MaZderMind/jukebox/hardware/pi-hat/3d/front.png

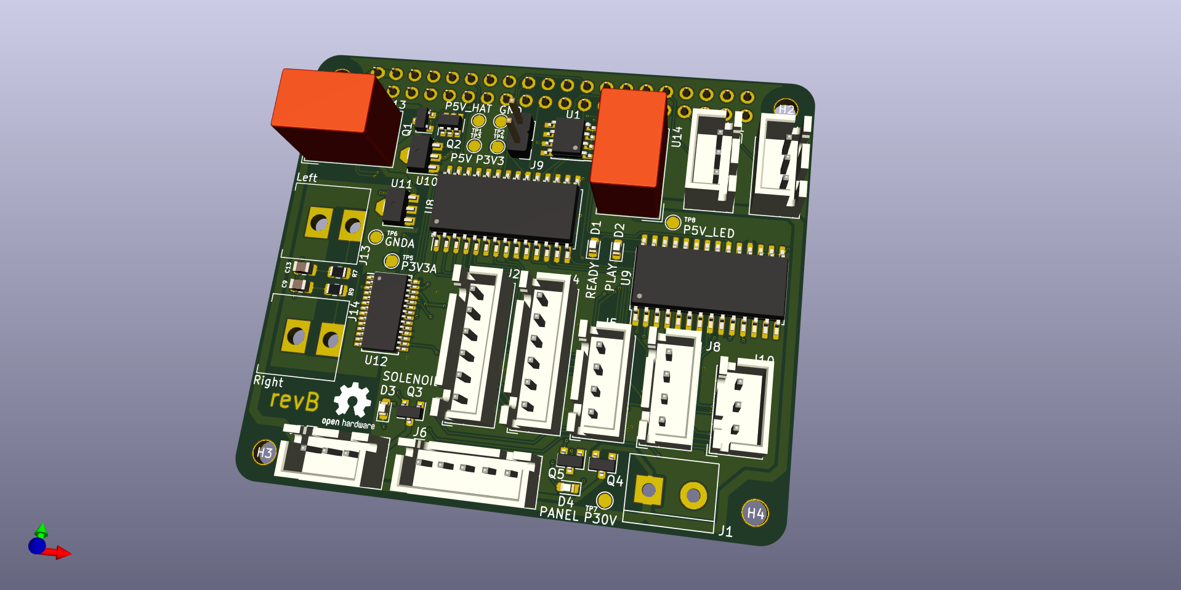
hardware/pi-hat/3d/front.png
