MaZderMind/jukebox/hardware/pi-hat/3d/back.png

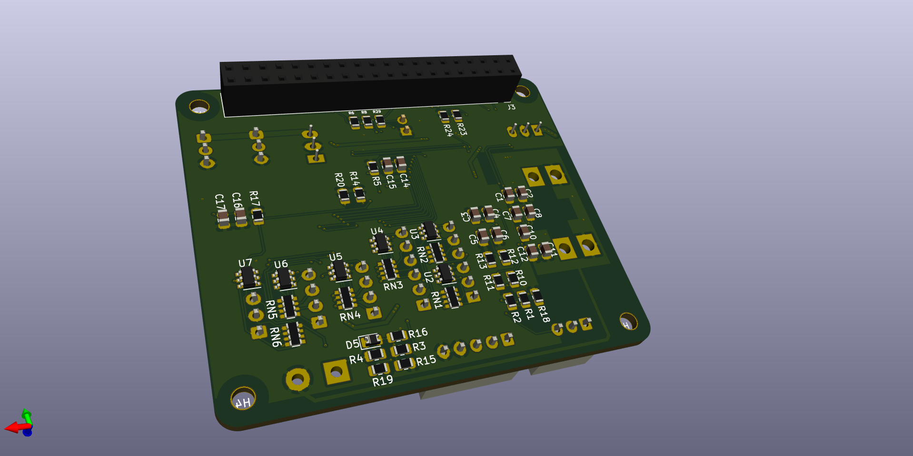
hardware/pi-hat/3d/back.png
