MaZderMind/jukebox/config/README.md

# Compile jukebox-Device-Tree
…

# Enable Device-Tree-Overlays
Add to /boot/config.txt

```
dtoverlay=jukebox
dtoverlay=hifiberry-dacplus
```
