MaZderMind/jukebox/hardware/pi-hat/schematic.pdf

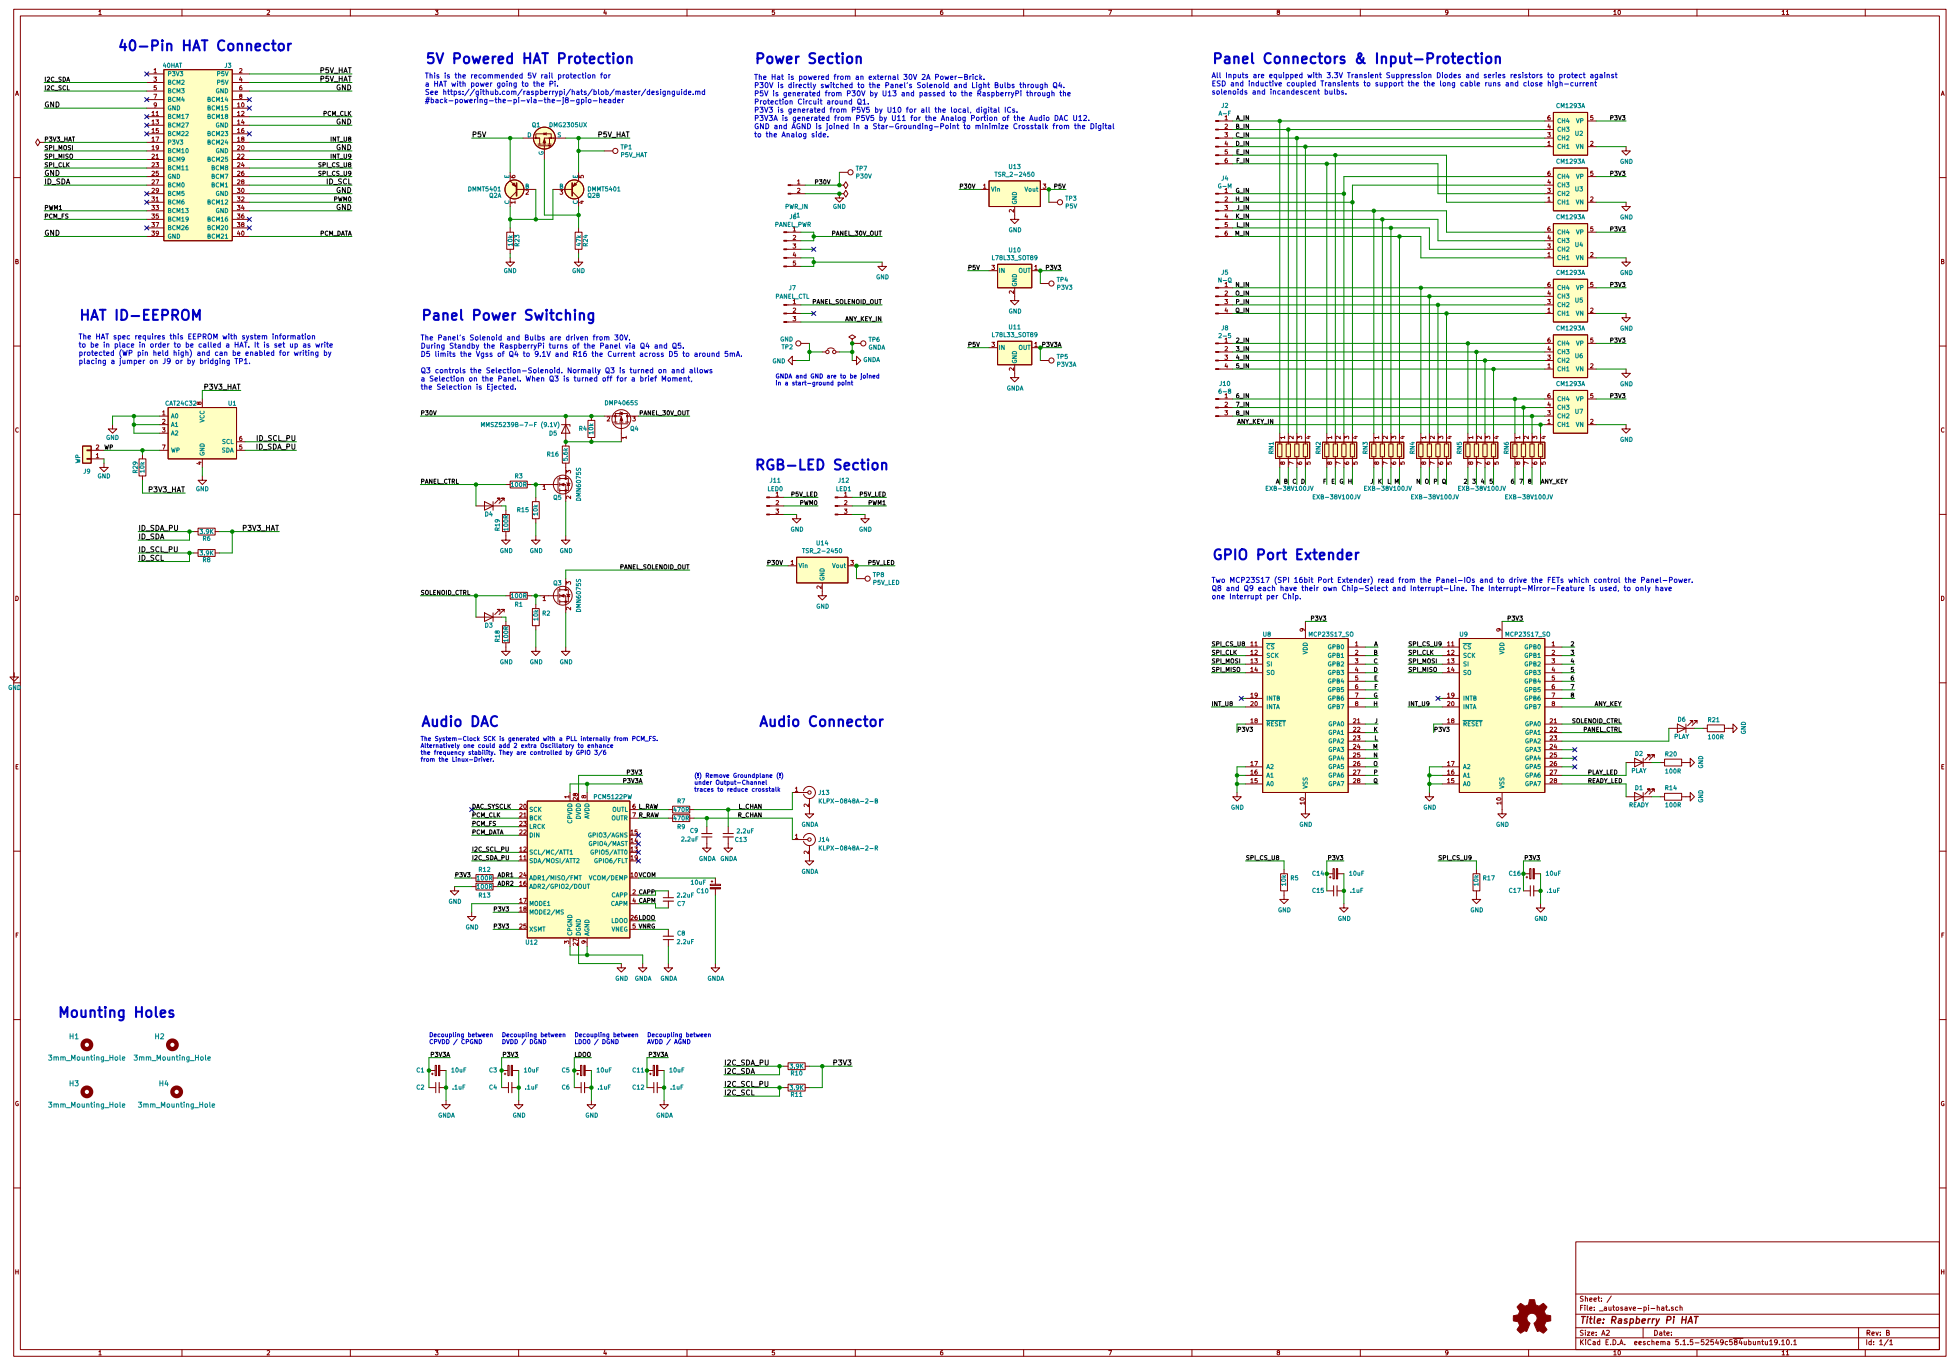
[picture p3: page 1]

ESD and inductive coupled Transients to support the the long cable runs and close high-current solenoids and incandescent bulbs. This is the recommended 5V rail protection for
a HAT with power going to the Pi.
See https://github.com/raspberrypi/hats/blob/master/designguide.md
#back-powering-the-pi-via-the-j8-gpio-header

The Hat is powered from an external 30V 2A Power-Brick.
P30V is directly switched to the Panel's Solenoid and Light Bulbs through Q4.
P5V is generated from P30V by U13 and passed to the RaspberryPi through the
Protection Circuit around Q1.
P3V3 is generated from P5V5 by U10 for all the local, digital ICs.
P3V3A is generated from P5V5 by U11 for the Analog Portion of the Audio DAC U12.
GND and AGND is joined in a Star-Grounding-Point to minimize Crosstalk from the Digital
to the Analog side.

All Inputs are equipped with 3.3V Transient Suppression Diodes and series resistors to protect against

The HAT spec requires this EEPROM with system information
to be in place in order to be called a HAT. It is set up as write
protected (WP pin held high) and can be enabled for writing by
placing a jumper on J9 or by bridging TP1.

8 A0 1 A1 2 A2 3 SDA 5 SCL 6 WP 7CAT24C32 U1 TP6 GNDA

The Panel's Solenoid and Bulbs are driven from 30V.
During Standby the RaspberryPi turns of the Panel via Q4 and Q5.
D5 limits the Vgss of Q4 to 9.1V and R16 the Current across D5 to around 5mA.

Q3 controls the Selection-Solenoid. Normally Q3 is turned on and allows
a Selection on the Panel. When Q3 is turned off for a brief Moment,
the Selection is Ejected.

GNDA and GND are to be joined
in a start-ground point

Two MCP23S17 (SPI 16bit Port Extender) read from the Panel-IOs and to drive the FETs which control the Panel-Power.
Q8 and Q9 each have their own Chip-Select and Interrupt-Line. The Interrupt-Mirror-Feature is used, to only have
one Interrupt per Chip.

The System-Clock SCK is generated with a PLL internally from PCM_FS.
Alternatively one could add 2 extra Oscillatory to enhance
the frequency stability. They are controlled by GPIO 3/6

(!) Remove Groundplane (!)
under Output-Channel traces to reduce crosstalk
3.9K GNDA GNDA

1 VCOM/DEMP 10 SDA/MOSI/ATT2 11 SCL/MC/ATT1 12 GPIO5/ATT0 13 GPIO4/MAST 14 GPIO3/AGNS 15 ADR2/GPIO2/DOUT 16 MODE1 17 MODE2/MS 18 GPIO6/FLT 19 CAPP 2 SCK 20 BCK 21 DIN 22

3 CAPM 4 VNEG 5 OUTL 6 OUTR 7 AVDD

R_RAW | 470R
LRCK 23 ADR1/MISO/FMT 24 XSMT 25

P3V3 | LDOO

Decoupling between CPVDD / CPGND

Decoupling between DVDD / DGND

Decoupling between AVDD / AGND

Id: 1/1 Title: Raspberry Pi HAT
