MaZderMind/jukebox/hardware/pi-hat/pi-hat.kicad_pcb

## KiCad design hardware/pi-hat/pi-hat.kicad_pcb (2020-01-15)

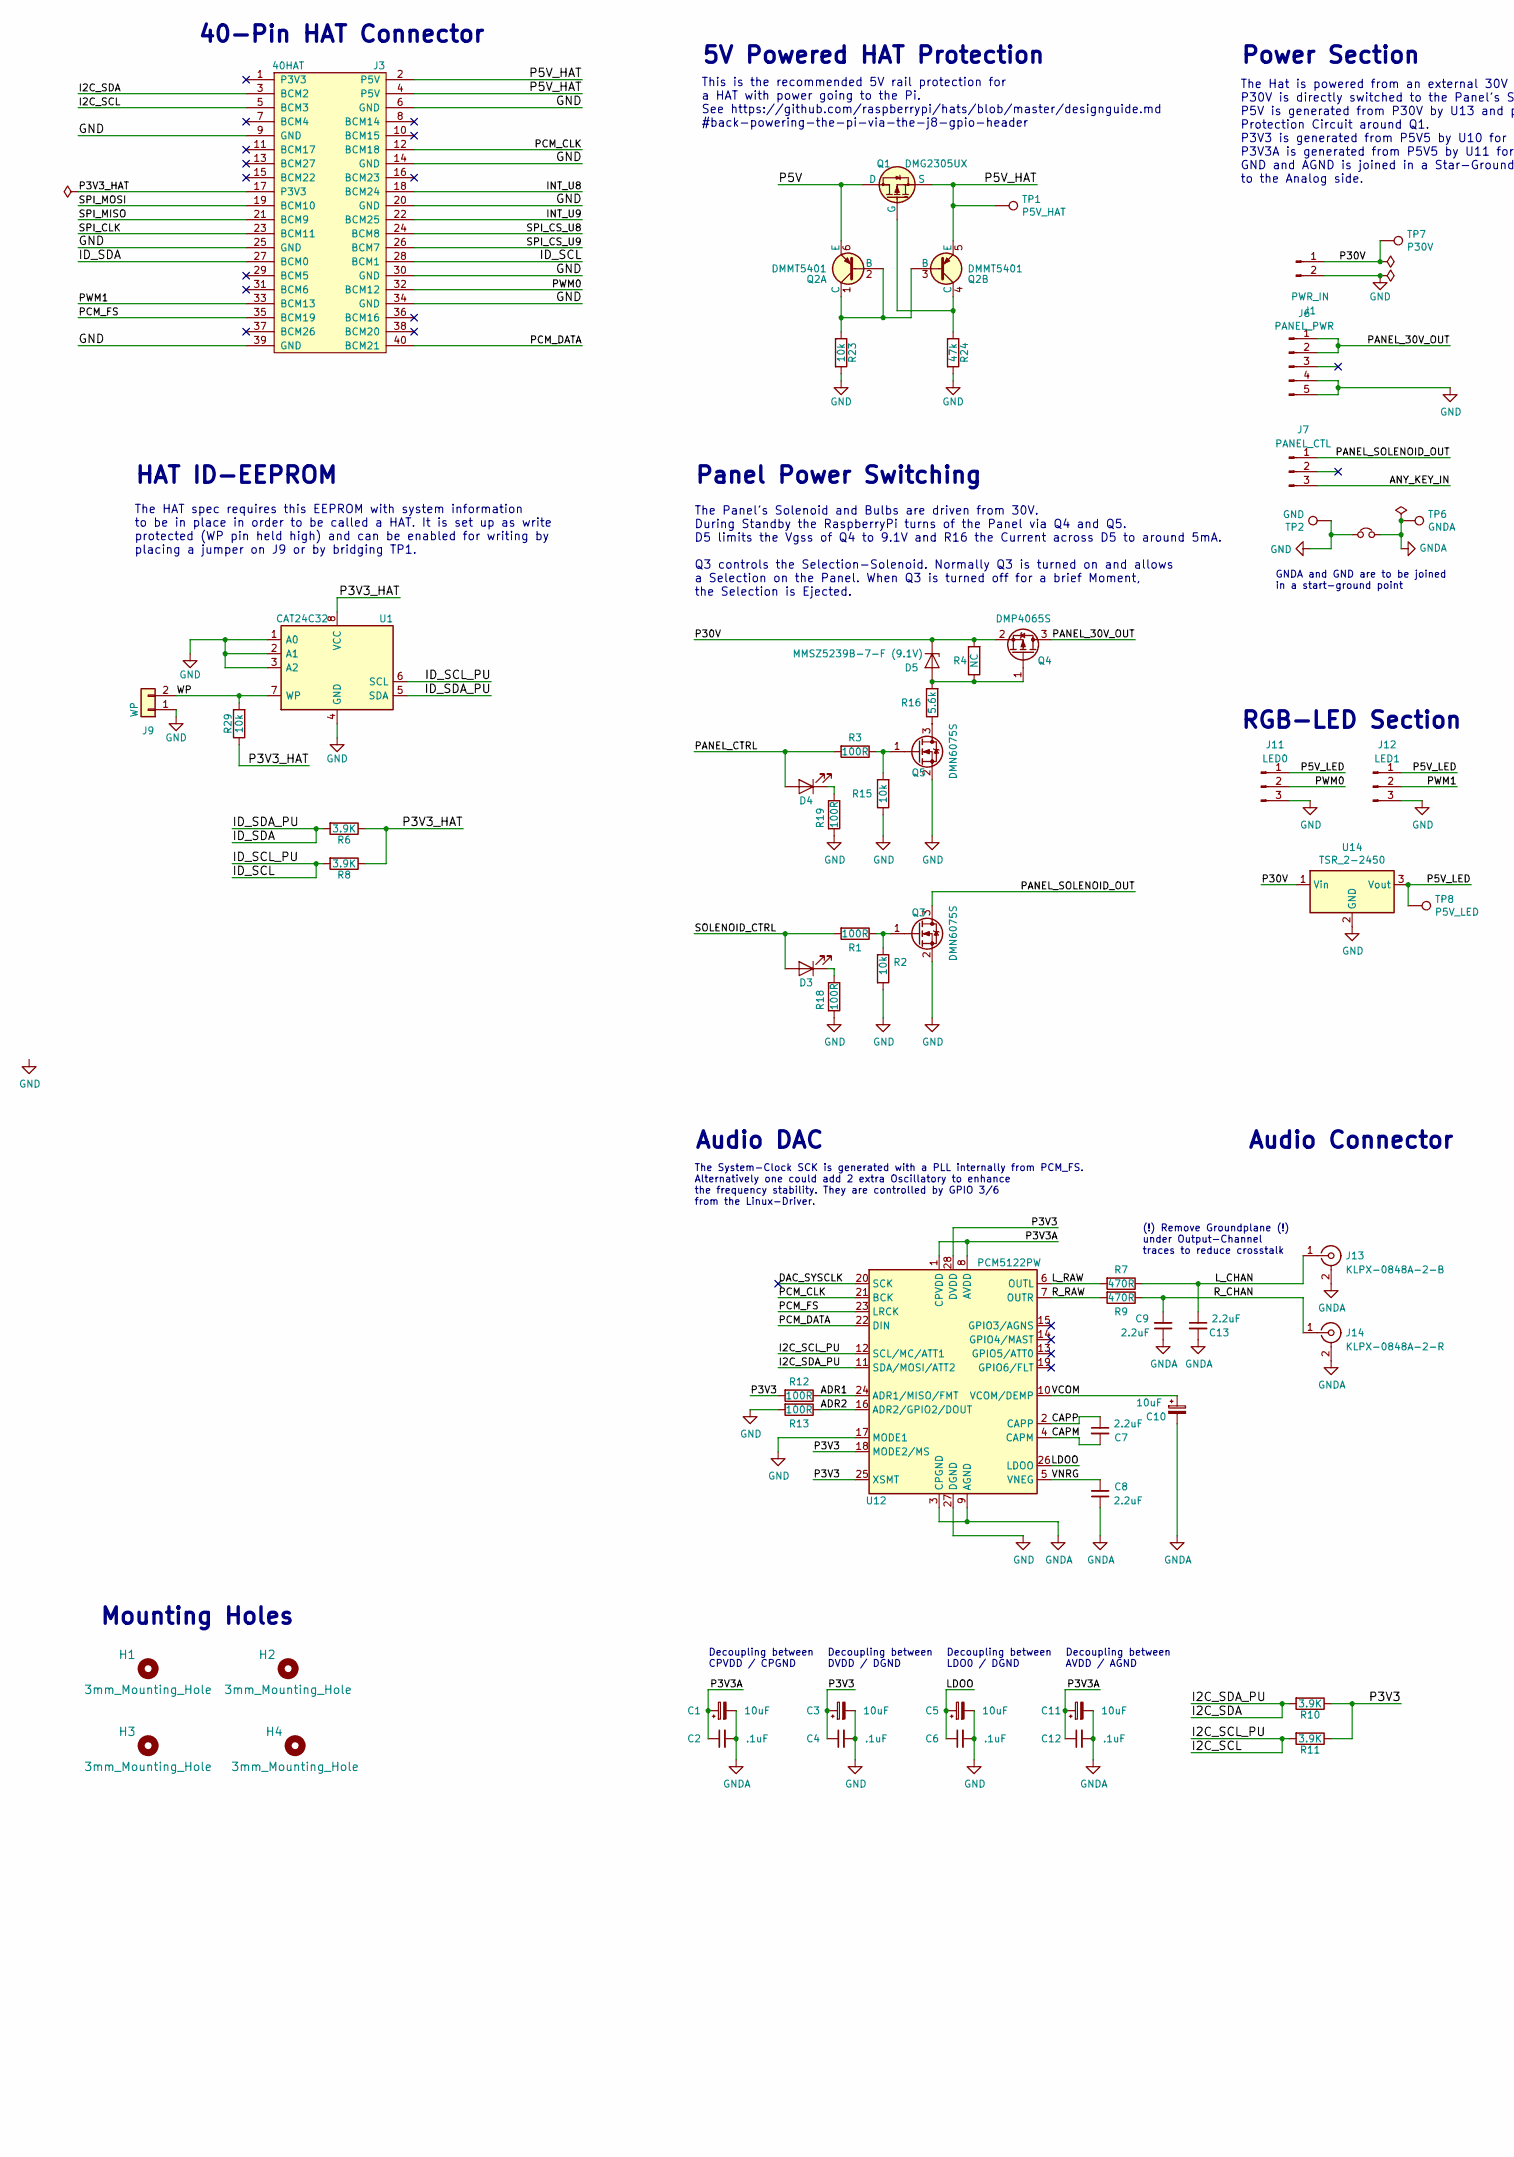
[picture p4: schematic pi-hat.sch, Raspberry Pi HAT, part in row 1, column 1]

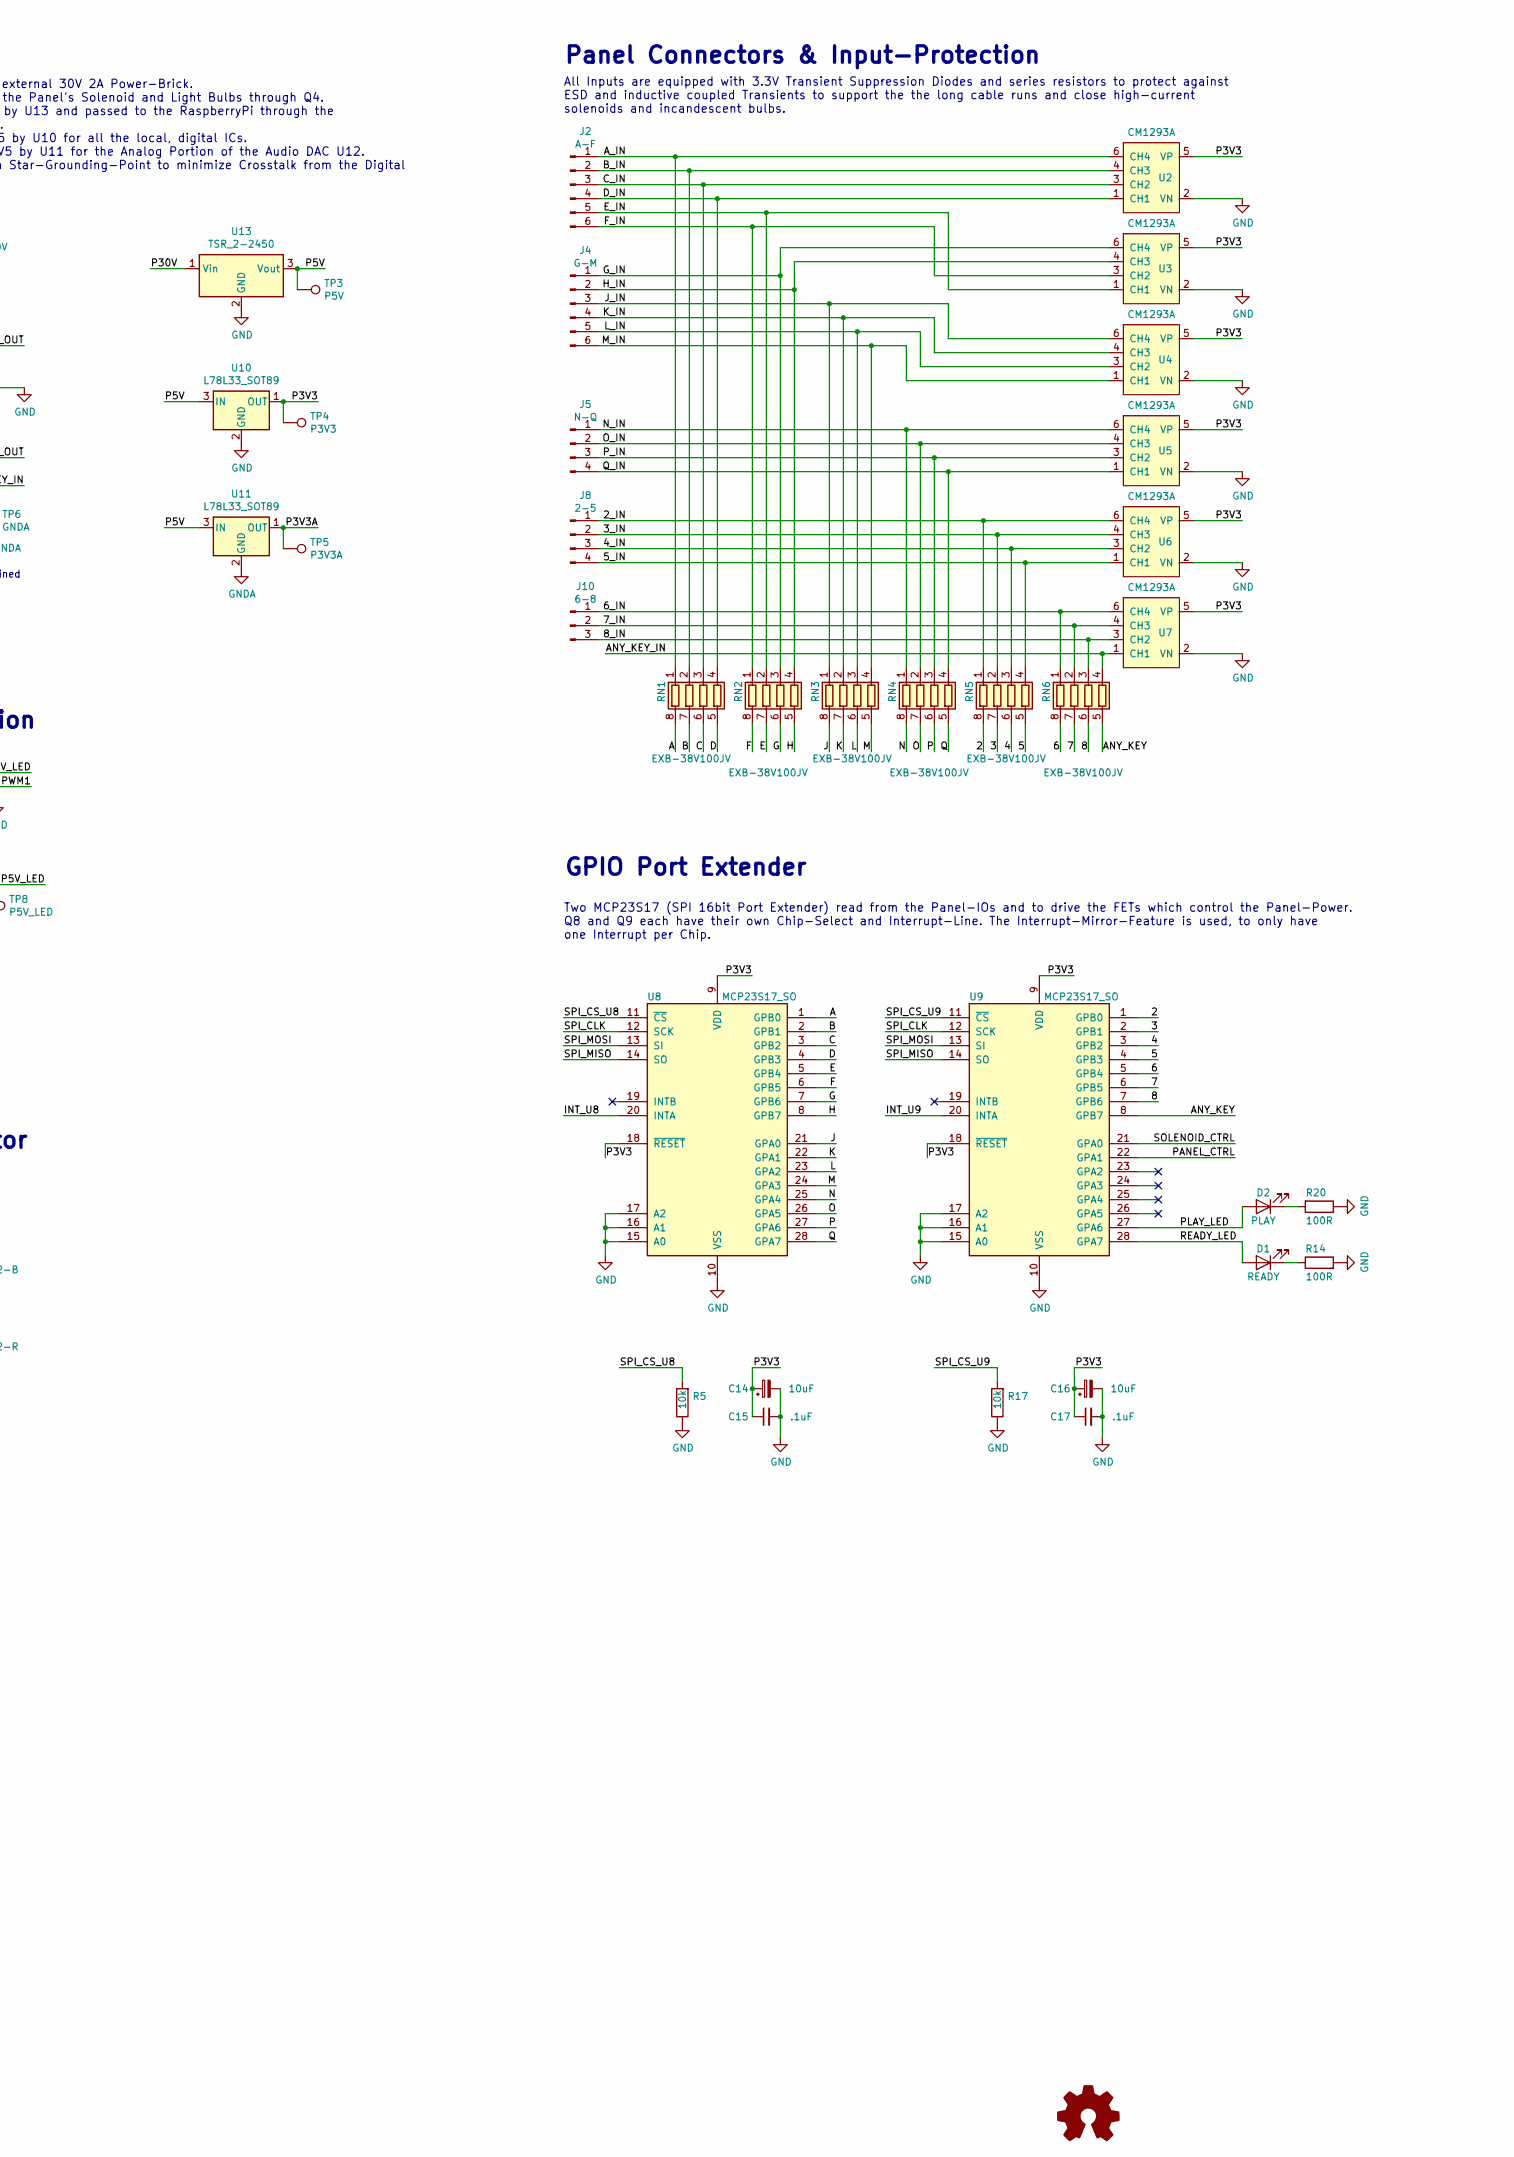
[picture p5: schematic pi-hat.sch, Raspberry Pi HAT, part in row 1, column 2]

Parts:
C1, C3, C5, C10, C11, C14, C16: 10uF; C_0805_2012Metric
C2, C4, C6, C12, C15, C17: .1uF; C_0805_2012Metric
C7, C8, C9, C13: 2.2uF; C_0805_2012Metric
D1: READY; LED_0603_1608Metric
D2: PLAY; LED_0603_1608Metric
D3: SOLENOID; LED_0603_1608Metric
D4: PANEL; LED_0603_1608Metric
D5: MMSZ5239B-7-F (9.1V); D_0805_2012Metric
H1, H2, H3, H4: 3mm_Mounting_Hole; NPTH_3mm_ID
J1: PWR_IN; WUERTH-2-5mm
J2: A-F; JST_XH_B6B-XH-A_1x06_P2.50mm_Vertical
J3: 40HAT; PinSocket_2x20_P2.54mm_Vertical
J4: G-M; JST_XH_B6B-XH-A_1x06_P2.50mm_Vertical
J5: N-Q; JST_XH_B4B-XH-A_1x04_P2.50mm_Vertical
J6: PANEL_PWR; JST_XH_B5B-XH-A_1x05_P2.50mm_Vertical
J7: PANEL_CTL; JST_XH_B3B-XH-A_1x03_P2.50mm_Vertical
J8: 2-5; JST_XH_B4B-XH-A_1x04_P2.50mm_Vertical
J9: WP; PinHeader_1x02_P2.54mm_Vertical
J10: 6-8; JST_XH_B3B-XH-A_1x03_P2.50mm_Vertical
J11: LED0; JST_XH_B3B-XH-A_1x03_P2.50mm_Vertical
J12: LED1; JST_XH_B3B-XH-A_1x03_P2.50mm_Vertical
J13: KLPX-0848A-2-B; KLPX_RCA
J14: KLPX-0848A-2-R; KLPX_RCA
JP1: Jumper_NC_Small; NetTie-2_SMD_Pad0.5mm
OSHW1: Logo_Open_Hardware_Large; OSHW-Logo2_7.3x6mm_SilkScreen
Q1: DMG2305UX; SOT-23
Q2: DMMT5401; SOT-23-6
Q3, Q5: DMN6075S; SOT-23
Q4: DMP4065S; SOT-23
R1, R3, R12, R13, R14, R18, R19, R20: 100R; R_0805_2012Metric
R2, R5, R15, R17, R23, R29: 10k; R_0805_2012Metric
R4: NC; R_0805_2012Metric
R6, R8, R10, R11: 3.9K; R_0805_2012Metric
R7, R9: 470R; R_0805_2012Metric
R16: 5.6k; R_0805_2012Metric
R24: 47k; R_0805_2012Metric
RN1, RN2, RN3, RN4, RN5, RN6: EXB-38V100JV; R_Array_Convex_4x0603
TP1: P5V_HAT; TestPoint_Pad_D1.5mm
TP2: GND; TestPoint_Pad_D1.5mm
TP3: P5V; TestPoint_Pad_D1.5mm
TP4: P3V3; TestPoint_Pad_D1.5mm
TP5: P3V3A; TestPoint_Pad_D1.5mm
TP6: GNDA; TestPoint_Pad_D1.5mm
TP7: P30V; TestPoint_Pad_D1.5mm
TP8: P5V_LED; TestPoint_Pad_D1.5mm
U1: CAT24C32; SOIC-8_3.9x4.9mm_P1.27mm
U2, U3, U4, U5, U6, U7: CM1293A; TSOP-6_1.65x3.05mm_P0.95mm
U8, U9: MCP23S17_SO; SOIC-28W_7.5x17.9mm_P1.27mm
U10, U11: L78L33_SOT89; SOT-89-3
U12: PCM5122PW; TSSOP-28_4.4x9.7mm_P0.65mm
U13, U14: TSR_2-2450; Converter_DCDC_TRACO_TSR-1_THT

Connections:
/2: RN5.8 (R1.2), U9.1 (GPB0)
/2_IN: J8.1, RN5.1 (R1.1), U6.6 (CH4)
/3: RN5.7 (R2.2), U9.2 (GPB1)
/3_IN: J8.2, RN5.2 (R2.1), U6.4 (CH3)
/4: RN5.6 (R3.2), U9.3 (GPB2)
/4_IN: J8.3, RN5.3 (R3.1), U6.3 (CH2)
/5: RN5.5 (R4.2), U9.4 (GPB3)
/5_IN: J8.4, RN5.4 (R4.1), U6.1 (CH1)
/6: RN6.8 (R1.2), U9.5 (GPB4)
/6_IN: J10.1, RN6.1 (R1.1), U7.6 (CH4)
/7: RN6.7 (R2.2), U9.6 (GPB5)
/7_IN: J10.2, RN6.2 (R2.1), U7.4 (CH3)
/8: RN6.6 (R3.2), U9.7 (GPB6)
/8_IN: J10.3, RN6.3 (R3.1), U7.3 (CH2)
/A: RN1.8 (R1.2), U8.1 (GPB0)
/ADR1: R12.1, U12.24 (ADR1/MISO/FMT)
/ADR2: R13.1, U12.16 (ADR2/GPIO2/DOUT)
/ANY_KEY: RN6.5 (R4.2), U9.8 (GPB7)
/ANY_KEY_IN: J7.3, RN6.4 (R4.1), U7.1 (CH1)
/A_IN: J2.1, RN1.1 (R1.1), U2.6 (CH4)
/B: RN1.7 (R2.2), U8.2 (GPB1)
/B_IN: J2.2, RN1.2 (R2.1), U2.4 (CH3)
/C: RN1.6 (R3.2), U8.3 (GPB2)
/CAPM: C7.2, U12.4 (CAPM)
/CAPP: C7.1, U12.2 (CAPP)
/C_IN: J2.3, RN1.3 (R3.1), U2.3 (CH2)
/D: RN1.5 (R4.2), U8.4 (GPB3)
/D_IN: J2.4, RN1.4 (R4.1), U2.1 (CH1)
/E: RN2.7 (R2.2), U8.5 (GPB4)
/E_IN: J2.5, RN2.2 (R2.1), U3.1 (CH1)
/F: RN2.8 (R1.2), U8.6 (GPB5)
/F_IN: J2.6, RN2.1 (R1.1), U3.3 (CH2)
/G: RN2.6 (R3.2), U8.7 (GPB6)
/G_IN: J4.1, RN2.3 (R3.1), U3.6 (CH4)
/H: RN2.5 (R4.2), U8.8 (GPB7)
/H_IN: J4.2, RN2.4 (R4.1), U3.4 (CH3)
/I2C_SCL: J3.5 (BCM3), R11.2, U12.12 (SCL/MC/ATT1)
/I2C_SDA: J3.3 (BCM2), R10.2, U12.11 (SDA/MOSI/ATT2)
/ID_SCL: J3.28 (BCM1), R8.2, U1.6 (SCL)
/ID_SDA: J3.27 (BCM0), R6.2, U1.5 (SDA)
/INT_U8: J3.18 (BCM24), U8.20 (INTA)
/INT_U9: J3.22 (BCM25), U9.20 (INTA)
/J: RN3.8 (R1.2), U8.21 (GPA0)
/J_IN: J4.3, RN3.1 (R1.1), U4.6 (CH4)
/K: RN3.7 (R2.2), U8.22 (GPA1)
/K_IN: J4.4, RN3.2 (R2.1), U4.4 (CH3)
/L: RN3.6 (R3.2), U8.23 (GPA2)
/LDOO: C5.1, C6.1, U12.26 (LDOO)
/L_CHAN: C13.1, J13.1 (In), R7.1
/L_IN: J4.5, RN3.3 (R3.1), U4.3 (CH2)
/L_RAW: R7.2, U12.6 (OUTL)
/M: RN3.5 (R4.2), U8.24 (GPA3)
/M_IN: J4.6, RN3.4 (R4.1), U4.1 (CH1)
/N: RN4.8 (R1.2), U8.25 (GPA4)
/N_IN: J5.1, RN4.1 (R1.1), U5.6 (CH4)
/O: RN4.7 (R2.2), U8.26 (GPA5)
/O_IN: J5.2, RN4.2 (R2.1), U5.4 (CH3)
/P: RN4.6 (R3.2), U8.27 (GPA6)
/P3V3: C3.1, C4.1, C14.1, C15.1, C16.1, C17.1, R10.1, R11.1, R12.2, TP4.1, U2.5 (VP), U3.5 (VP), U4.5 (VP), U5.5 (VP), U6.5 (VP), U7.5 (VP), U8.9 (VDD), U8.18 (~RESET~), U9.9 (VDD), U9.18 (~RESET~), U10.1 (OUT), U12.18 (MODE2/MS), U12.25 (XSMT), U12.28 (DVDD)
/P3V3A: C1.1, C2.1, C11.1, C12.1, TP5.1, U11.1 (OUT), U12.1 (CPVDD), U12.8 (AVDD)
/P3V3_HAT: J3.17 (P3V3), R6.1, R8.1, R29.1, U1.8 (VCC)
/P5V: Q1.3 (D), Q2.6 (E), TP3.1, U10.3 (IN), U11.3 (IN), U13.3 (Vout)
/P5V_HAT: J3.2 (P5V), J3.4 (P5V), Q1.2 (S), Q2.5 (E), TP1.1
/P5V_LED: J11.1, J12.1, TP8.1, U14.3 (Vout)
/P30V: D5.1 (K), J1.1, Q4.2 (S), R4.2, TP7.1, U13.1 (Vin), U14.1 (Vin)
/PANEL_30V_OUT: J6.1, J6.2, Q4.3 (D)
/PANEL_CTRL: D4.2 (A), R3.2, U9.22 (GPA1)
/PANEL_SOLENOID_OUT: J7.1, Q3.3 (D)
/PCM_CLK: J3.12 (BCM18), U12.21 (BCK)
/PCM_DATA: J3.40 (BCM21), U12.22 (DIN)
/PCM_FS: J3.35 (BCM19), U12.23 (LRCK)
/PLAY_LED: D2.2 (A), U9.27 (GPA6)
/PWM0: J3.32 (BCM12), J11.2
/PWM1: J3.33 (BCM13), J12.2
/P_IN: J5.3, RN4.3 (R3.1), U5.3 (CH2)
/Q: RN4.5 (R4.2), U8.28 (GPA7)
/Q_IN: J5.4, RN4.4 (R4.1), U5.1 (CH1)
/READY_LED: D1.2 (A), U9.28 (GPA7)
/R_CHAN: C9.2, J14.1 (In), R9.1
/R_RAW: R9.2, U12.7 (OUTR)
/SOLENOID_CTRL: D3.2 (A), R1.2, U9.21 (GPA0)
/SPI_CLK: J3.23 (BCM11), U8.12 (SCK), U9.12 (SCK)
/SPI_CS_U8: J3.24 (BCM8), R5.2, U8.11 (~CS~)
/SPI_CS_U9: J3.26 (BCM7), R17.2, U9.11 (~CS~)
/SPI_MISO: J3.21 (BCM9), U8.14 (SO), U9.14 (SO)
/SPI_MOSI: J3.19 (BCM10), U8.13 (SI), U9.13 (SI)
/VCOM: C10.1, U12.10 (VCOM/DEMP)
/VNRG: C8.2, U12.5 (VNEG)
/WP: J9.2, R29.2, U1.7 (WP)
GND: C3.2, C4.2, C5.2, C6.2, C14.2, C15.2, C16.2, C17.2, J1.2, J3.6 (GND), J3.9 (GND), J3.14 (GND), J3.20 (GND), J3.25 (GND), J3.30 (GND), J3.34 (GND), J3.39 (GND), J6.4, J6.5, J9.1, J11.3, J12.3, JP1.1, Q3.2 (S), Q5.2 (S), R2.2, R5.1, R13.2, R14.2, R15.1, R17.1, R18.2, R19.2, R20.1, R23.2, R24.2, TP2.1, U1.1 (A0), U1.2 (A1), U1.3 (A2), U1.4 (GND), U2.2 (VN), U3.2 (VN), U4.2 (VN), U5.2 (VN), U6.2 (VN), U7.2 (VN), U8.10 (VSS), U8.15 (A0), U8.16 (A1), U8.17 (A2), U9.10 (VSS), U9.15 (A0), U9.16 (A1), U9.17 (A2), U10.2 (GND), U12.17 (MODE1), U12.27 (DGND), U13.2 (GND), U14.2 (GND)
GNDA: C1.2, C2.2, C8.1, C9.1, C10.2, C11.2, C12.2, C13.2, J13.2 (Ext), J14.2 (Ext), JP1.2, TP6.1, U11.2 (GND), U12.3 (CPGND), U12.9 (AGND)
unnamed: D1.1 (K), R14.1
unnamed: D2.1 (K), R20.2
unnamed: D3.1 (K), R18.1
unnamed: D4.1 (K), R19.1
unnamed: D5.2 (A), Q4.1 (G), R4.1, R16.2
unnamed: Q1.1 (G), Q2.4 (C), R24.1
unnamed: Q2.1 (C), Q2.2 (B), Q2.3 (B), R23.1
unnamed: Q3.1 (G), R1.1, R2.1
unnamed: Q5.1 (G), R3.1, R15.2
unnamed: Q5.3 (D), R16.1

Notes on the sheet:
HAT ID-EEPROM
The HAT spec requires this EEPROM with system information to be in place in order to be called a HAT. It is set up as write protected (WP pin held high) and can be enabled for writing by placing a jumper on J9 or by bridging TP1.
Power Section
The Hat is powered from an external 30V 2A Power-Brick. P30V is directly switched to the Panel's Solenoid and Light Bulbs through Q4. P5V is generated from P30V by U13 and passed to the RaspberryPi through the Protection Circuit around Q1. P3V3 is generated from P5V5 by U10 for all the local, digit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
Mounting Holes
All Inputs are equipped with 3.3V Transient Suppression Diodes and series resistors to protect against ESD and inductive coupled Transients to support the the long cable runs and close high-current solenoids and incandescent bulbs.
Panel Connectors & Input-Protection
Panel Power Switching
Audio Connector
RGB-LED Section
40-Pin HAT Connector
This is the recommended 5V rail protection for a HAT with power going to the Pi. See https://github.com/raspberrypi/hats/blob/master/designguide.md #back-powering-the-pi-via-the-j8-gpio-header
5V Powered HAT Protection
(!) Remove Groundplane (!) under Output-Channel traces to reduce crosstalk
Decoupling between CPVDD / CPGND
Decoupling between DVDD / DGND
Decoupling between LDO0 / DGND
Decoupling between AVDD / AGND
The System-Clock SCK is generated with a PLL internally from PCM_FS. Alternatively one could add 2 extra Oscillatory to enhance the frequency stability. They are controlled by GPIO 3/6 from the Linux-Driver.
Audio DAC
GNDA and GND are to be joined in a start-ground point
GPIO Port Extender
Two MCP23S17 (SPI 16bit Port Extender) read from the Panel-IOs and to drive the FETs which control the Panel-Power. Q8 and Q9 each have their own Chip-Select and Interrupt-Line. The Interrupt-Mirror-Feature is used, to only have one Interrupt per Chip.
The Panel's Solenoid and Bulbs are driven from 30V. During Standby the RaspberryPi turns of the Panel via Q4 and Q5. D5 limits the Vgss of Q4 to 9.1V and R16 the Current across D5 to around 5mA. Q3 controls the Selection-Solenoid. Normally Q3 is turned on and allows a Selection on the Panel. When Q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

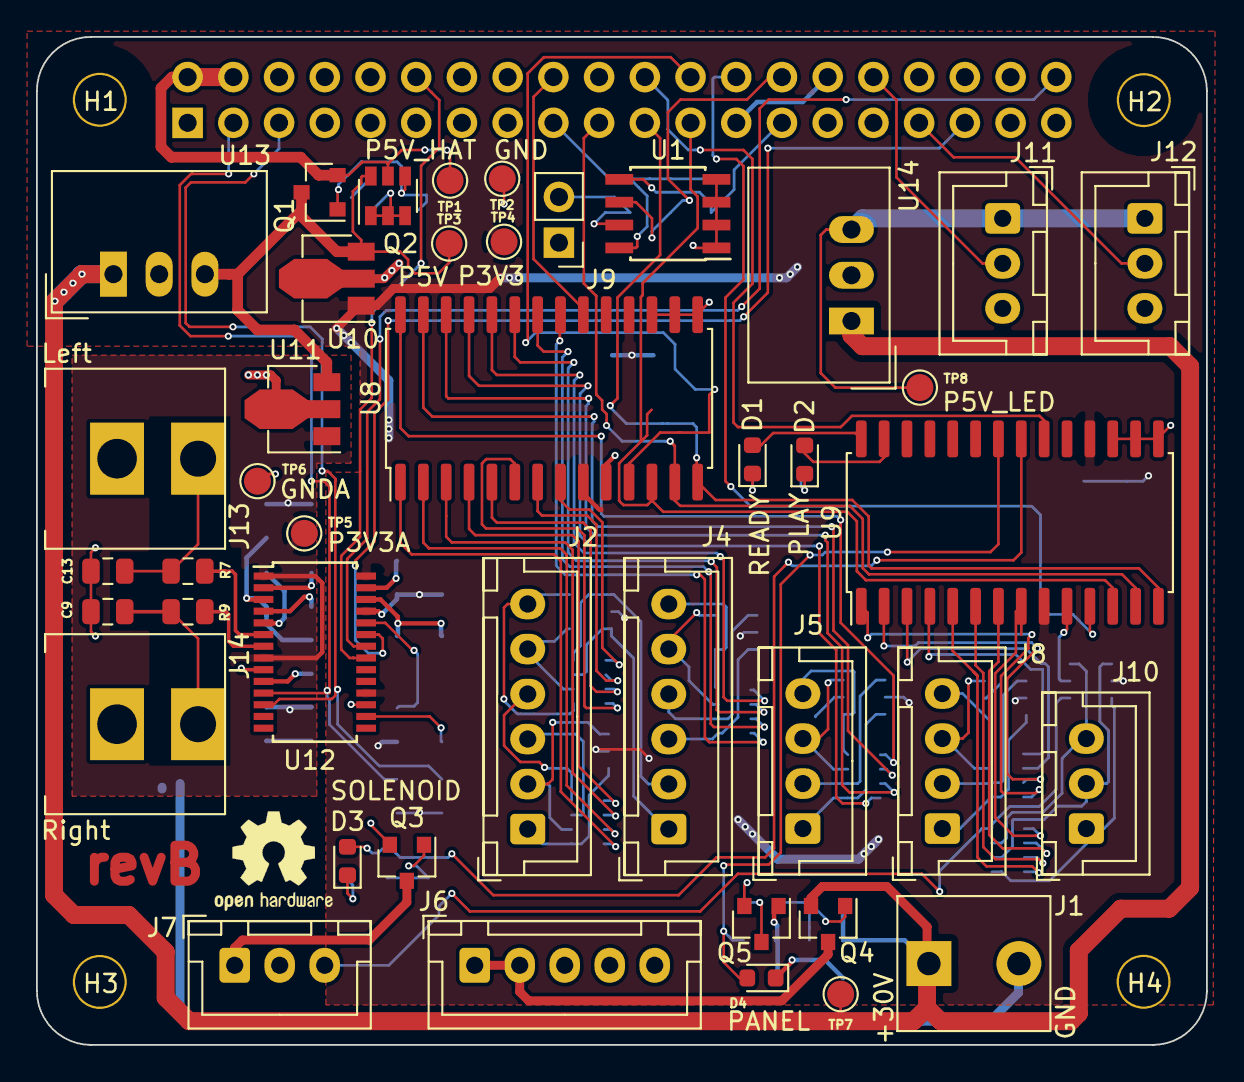
[picture p6: board pi-hat.kicad_pcb from above]

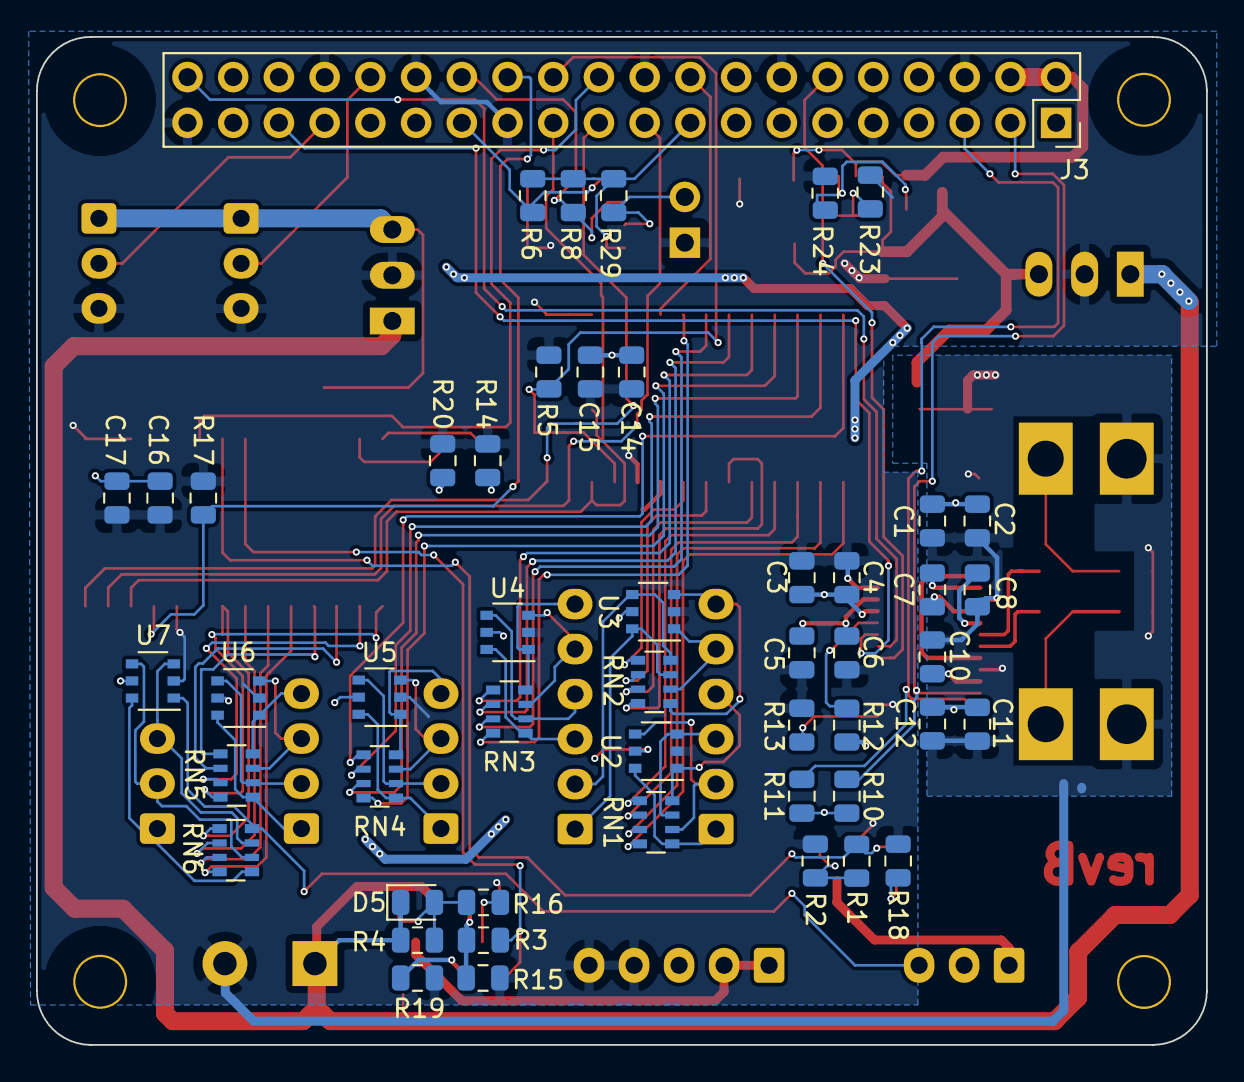
[picture p7: board pi-hat.kicad_pcb from below]

Board: 2 copper layers, 65.0 x 56.0 mm, 98 parts (51 on the bottom side), 101 nets.
