MaZderMind/jukebox/(commit log)

2019-12-10 initial design
    [pi-hat.kicad_pcb, pi-hat.sch]
2019-12-14 panel switch fets
    [pi-hat.sch]
2019-12-14 cleanup and documentation
    [pi-hat.sch]
2019-12-14 footprint assignments and early board layout
    [pi-hat.kicad_pcb, pi-hat.sch]
2019-12-14 first power traces
    [pi-hat.kicad_pcb, pi-hat.sch]
2019-12-15 add audio section with split gnd and 3v3
    [pi-hat.kicad_pcb, pi-hat.sch]
2019-12-15 route io protection
    [pi-hat.kicad_pcb, pi-hat.sch]
2019-12-15 add pdf schematic
2019-12-15 fully routed
    [pi-hat.kicad_pcb, pi-hat.sch]
2019-12-17 fiddle with groundplanes and gnd routing
    [pi-hat.kicad_pcb]
2019-12-17 add icons and voltage testpoints
    [pi-hat.kicad_pcb, pi-hat.sch]
2019-12-17 add indicator led
    [pi-hat.kicad_pcb, pi-hat.sch]
2019-12-17 generate gerbers and updated schematic pdf
    [pi-hat-B_Cu.gbr, pi-hat-B_Mask.gbr, pi-hat-B_Paste.gbr, pi-hat-B_SilkS.gbr, pi-hat-Edge_Cuts.gbr, pi-hat-F_Cu.gbr, pi-hat-F_Mask.gbr, pi-hat-F_Paste.gbr]
2019-12-17 add jumper to optionally bridge pcm_clk and sclk as per datasheet
    [pi-hat.kicad_pcb, pi-hat.sch]
2019-12-17 final cleanup and order
    [pi-hat-B_Cu.gbr, pi-hat-B_Mask.gbr, pi-hat-B_Paste.gbr, pi-hat-B_SilkS.gbr, pi-hat-Edge_Cuts.gbr, pi-hat-F_Cu.gbr, pi-hat-F_Mask.gbr, pi-hat-F_Paste.gbr]
2019-12-21 change topology around Q4
    [pi-hat.kicad_pcb, pi-hat.sch]
2020-01-01 fix U/9 RESET to P3V3
    [pi-hat.sch]
2020-01-01 split CS between U8/U9, GND Address-Lines, Rename Interrupt-Lines
    [pi-hat.sch]
2020-01-01 fix MISO/MOSI flip
    [pi-hat.sch]
2020-01-01 add LEDs for PLAY, SOLENOID and PANEL Indicaton
    [pi-hat.sch]
2020-01-01 flip E/F
    [pi-hat.sch]
2020-01-01 add TSR-2-2450 local 5V DC/DC converter and 30V Screw-Terminal
    [pi-hat.sch]
2020-01-01 clarify some labels
    [pi-hat.sch]
2020-01-01 upsize paper and enhance schematic layout by using up more space.
    [pi-hat.sch]
2020-01-01 add specific P-Channel FET + Zener
    [pi-hat.sch]
2020-01-01 center GND/AGND join-point
    [pi-hat.sch]
2020-01-02 choose better Q4, D5 and R16; remove R4
    [pi-hat.sch]
2020-01-02 add R4 as NC back
    [pi-hat.sch]
2020-01-05 fix line/shield flip on RCA Connectors
2020-01-05 add 5V DC/DC Converter for LED-Strips
    [pi-hat.sch]
2020-01-05 shrink testpoints and sot-6 footprint
    [pi-hat.sch]
2020-01-05 remove sck/fs bridge option
    [pi-hat.sch]
2020-01-05 fix broken gnd, only install a single 5V 2A DC/DC for the LEDs
    [pi-hat.sch]
2020-01-05 re-configure board. route 30V and GND
    [pi-hat.kicad_pcb]
2020-01-05 route soundcard and 1st gpio extender
    [pi-hat.kicad_pcb]
2020-01-05 fix drc errors
    [pi-hat.kicad_pcb]
2020-01-06 fix rca connector pinout
    [pi-hat.kicad_pcb]
2020-01-07 fix routing
    [pi-hat.kicad_pcb]
2020-01-07 final routing and silkscreen cleanup
    [pi-hat.kicad_pcb]
2020-01-07 update 3d and gerbers
    [pi-hat-B_Cu.gbr, pi-hat-B_Mask.gbr, pi-hat-B_SilkS.gbr, pi-hat-Edge_Cuts.gbr, pi-hat-F_Cu.gbr, pi-hat-F_Mask.gbr, pi-hat-F_SilkS.gbr, pi-hat-NPTH.drl]
2020-01-07 insert correct WUERTH footprint
    [pi-hat-B_Cu.gbr, pi-hat-B_Mask.gbr, pi-hat-B_SilkS.gbr, pi-hat-Edge_Cuts.gbr, pi-hat-F_Cu.gbr, pi-hat-F_Mask.gbr, pi-hat-F_SilkS.gbr, pi-hat-NPTH.drl]
2020-01-15 move silkscreen labels
    [pi-hat.kicad_pcb]
2020-01-17 R4 needs to be 10k to discharge the Gate of Q4
    [pi-hat.sch]
2020-01-20 split jukebox controller and ledstrip-server
2020-01-20 minimal ledserver connection
2020-02-09 extend animation framework
2020-02-12 nicer interface for sequencing and interrupting
2020-02-13 interrupt on change
2020-02-13 only relase solenoid when keys are released
2020-02-13 reset current key-combo when invalid
2020-02-15 support secondary leds
2020-02-15 configure secondary leds
2020-02-19 fix secondary leds in-situ
2020-02-19 do not stop or restart secondary leds if already running
2020-02-22 better error-messages for missing spotify devices
2020-02-22 disable animation before sending the idle frame
2020-02-22 fix calculation of meter leds
2020-02-29 update schematic
2020-03-29 try to restart raspotify-service when the device vanishes
2021-02-13 add rotary-encoder for volume-control on gpio 14/15
2021-07-03 don't fail with v4 only devices
2021-07-03 can't get dualstack to work, resort to ipv4 only… grrr…
2021-07-18 fix secondary led sender
